rjehangir/PowerMonitor/README.md

PowerMonitor
============

Arduino-based power monitoring board with 4 channels for the SolarSurfer.
