rjehangir/PowerMonitor/eagle/power-monitor.brd

## EAGLE design eagle/power-monitor.brd (2014-09-27)

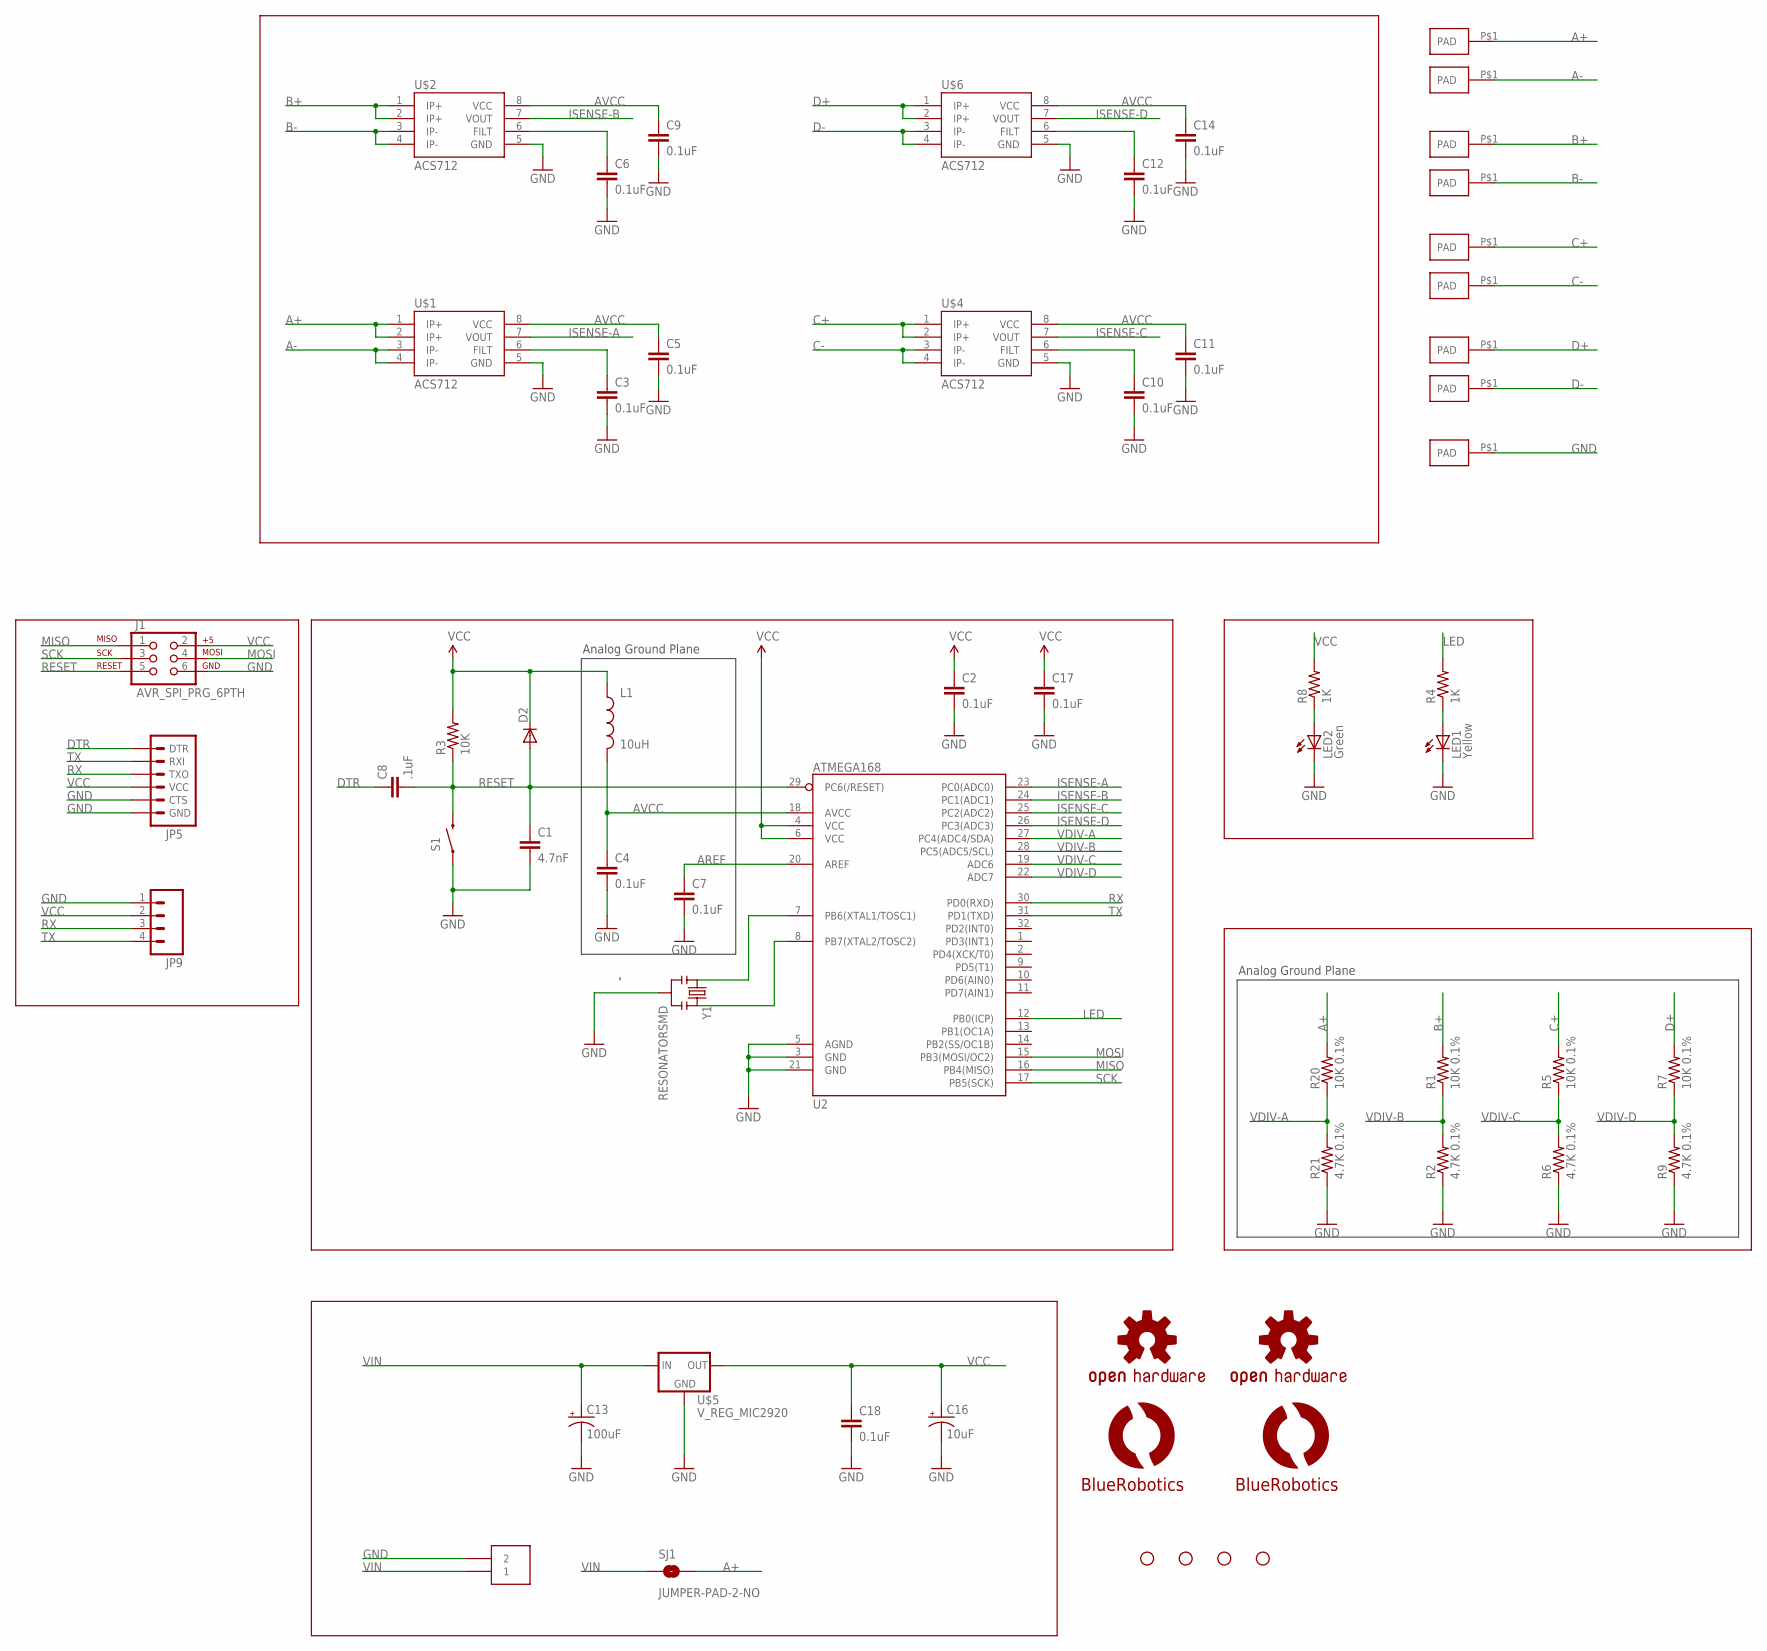
[picture p1: schematic power-monitor.sch]

Parts:
C1: 4.7nF; 0603-CAP
C2, C3, C4, C5, C6, C7, C9, C10, C11, C12, C14, C17, C18: 0.1uF; 0603-CAP
C8: .1uF; 0603-CAP
C13: 100uF; CPOL-RADIAL-100UF-25V
C16: 10uF; EIA3216
D2: DIODESOD; SOD-323
J1: AVR_SPI_PRG_6PTH; 2X3
JP5: ARDUINO_SERIAL_PROGRAMPTH; 1X06
JP9: M04PTH; 1X04
L1: 10uH; 0603
LED1: Yellow; LED-0603
LED2: Green; LED-0603
LOGO1: OSHW-LOGOS; OSHW-LOGO-S
LOGO2: OSHW-LOGOM; OSHW-LOGO-M
R1, R5, R7, R20: 10K 0.1%; 0603-RES
R2, R6, R9, R21: 4.7K 0.1%; 0603-RES
R3: 10K; 0603-RES
R4, R8: 1K; 0603-RES
S1: reset; TACTILE_SWITCH_SMD
SJ1: JUMPER-PAD-2-NO; PAD-JUMPER-2-NO_NO_SILK
STANDOFF1, STANDOFF2, STANDOFF3, STANDOFF4: STAND-OFF
U2: ATMEGA168; TQFP32-08
U$1, U$2, U$4, U$6: ACS712; SO08
U$3: TERMINAL-25MM-WEID; LSF-SMT-5MM-2
U$5: V_REG_MIC2920; SOT223
U$7, U$8, U$9, U$10, U$11, U$13, U$14, U$15, U$16: PADLARGE-ONE-SIDE; PAD-0.2X0.3-ONE-SIDE
U$17: LOGOBR-LOGO-M; BR-LOGO-MEDIUM
U$18: LOGOBR-LOGO-S; BR-LOGO-SMALL
Y1: RESONATORSMD; RESONATOR-SMD

Connections:
A+: R20.2, SJ1.2, U$1.1 (IP+), U$1.2 (IP+), U$13.P$1
A-: U$1.3 (IP-), U$1.4 (IP-), U$14.P$1
AREF: C7.1, U2.20 (AREF)
AVCC: C4.1, C5.1, C9.1, C11.1, C14.1, L1.2, U2.18 (AVCC), U$1.8 (VCC), U$2.8 (VCC), U$4.8 (VCC), U$6.8 (VCC)
B+: R1.2, U$2.1 (IP+), U$2.2 (IP+), U$15.P$1
B-: U$2.3 (IP-), U$2.4 (IP-), U$16.P$1
C+: R5.2, U$4.1 (IP+), U$4.2 (IP+), U$7.P$1
C-: U$4.3 (IP-), U$4.4 (IP-), U$8.P$1
D+: R7.2, U$6.1 (IP+), U$6.2 (IP+), U$9.P$1
D-: U$6.3 (IP-), U$6.4 (IP-), U$10.P$1
DTR: C8.1, JP5.1 (DTR)
GND: C1.2, C2.2, C3.2, C4.2, C5.2, C6.2, C7.2, C9.2, C10.2, C11.2, C12.2, C13.2 (-), C14.2, C16.C (-), C17.2, C18.2, J1.6, JP5.5 (CTS), JP5.6 (GND), JP9.1, LED1.C, LED2.C, R2.1, R6.1, R9.1, R21.1, S1.1, U2.3 (GND), U2.5 (AGND), U2.21 (GND), U$1.5 (GND), U$2.5 (GND), U$3.2, U$3.4 (2), U$4.5 (GND), U$5.2 (GND), U$6.5 (GND), U$11.P$1, Y1.2
ISENSE-A: U2.23 (PC0(ADC0)), U$1.7 (VOUT)
ISENSE-B: U2.24 (PC1(ADC1)), U$2.7 (VOUT)
ISENSE-C: U2.25 (PC2(ADC2)), U$4.7 (VOUT)
ISENSE-D: U2.26 (PC3(ADC3)), U$6.7 (VOUT)
LED: R4.2, U2.12 (PB0(ICP))
MISO: J1.1, U2.16 (PB4(MISO))
MOSI: J1.4, U2.15 (PB3(MOSI/OC2))
unnamed: C6.1, U$2.6 (FILT)
unnamed: C3.1, U$1.6 (FILT)
unnamed: LED1.A, R4.1
unnamed: C10.1, U$4.6 (FILT)
unnamed: C12.1, U$6.6 (FILT)
unnamed: U2.7 (PB6(XTAL1/TOSC1)), Y1.1
unnamed: U2.8 (PB7(XTAL2/TOSC2)), Y1.3
unnamed: LED2.A, R8.1
RESET: C1.1, C8.2, D2.2 (A), J1.5, R3.1, S1.3 (2), U2.29 (PC6(/RESET))
RX: JP5.3 (TXO), JP9.3, U2.30 (PD0(RXD))
SCK: J1.3, U2.17 (PB5(SCK))
TX: JP5.2 (RXI), JP9.4, U2.31 (PD1(TXD))
VCC: C2.1, C16.A (+), C17.1, C18.1, D2.1 (C), J1.2, JP5.4 (VCC), JP9.2, L1.1, R3.2, R8.2, U2.4 (VCC), U2.6 (VCC), U$5.3 (OUT)
VDIV-A: R20.1, R21.2, U2.27 (PC4(ADC4/SDA))
VDIV-B: R1.1, R2.2, U2.28 (PC5(ADC5/SCL))
VDIV-C: R5.1, R6.2, U2.19 (ADC6)
VDIV-D: R7.1, R9.2, U2.22 (ADC7)
VIN: C13.1 (+), SJ1.1, U$3.1, U$3.3 (1), U$5.1 (IN)

Notes on the sheet:
Analog Ground Plane

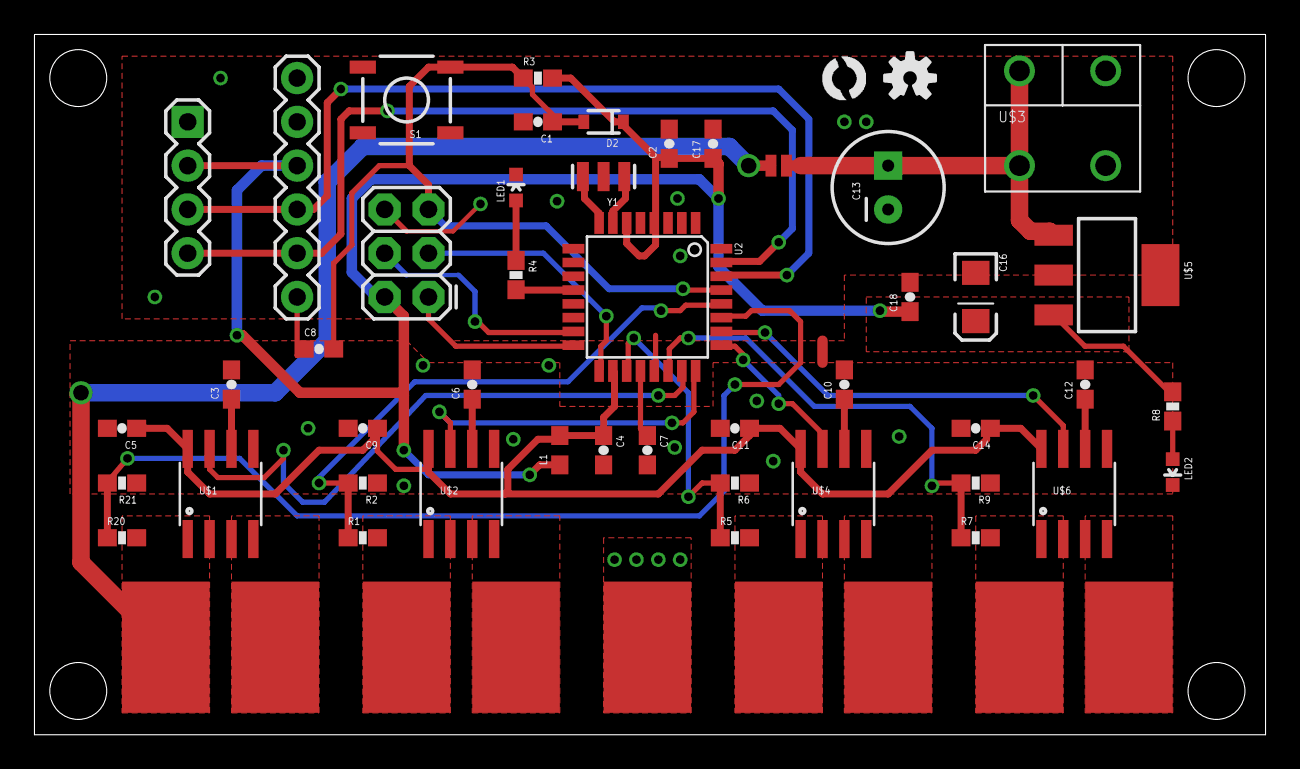
[picture p2: board power-monitor.brd from above]

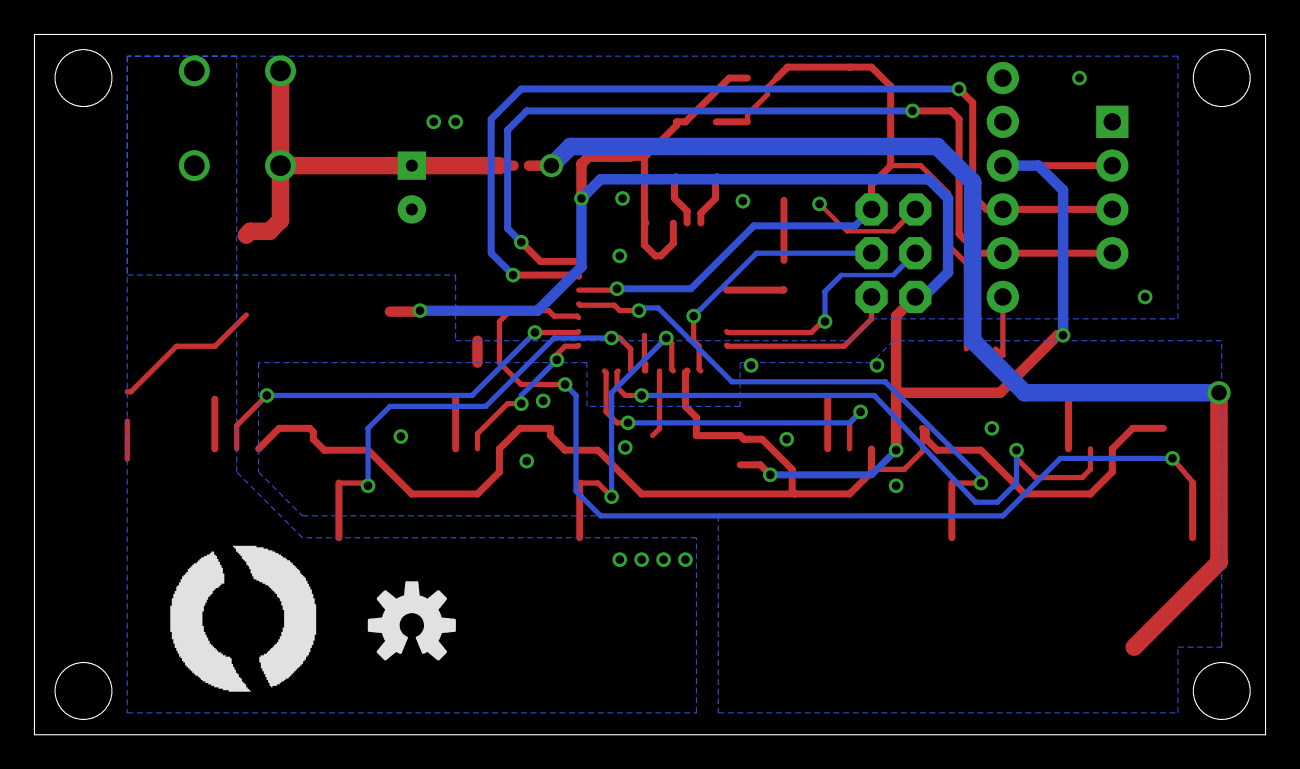
[picture p3: board power-monitor.brd from below]

Board: 2 copper layers, 71.4 x 40.6 mm, 62 parts (2 on the bottom side), 37 nets.
