rjehangir/PowerMonitor/(commit log)

2014-07-24 Tested the power monitor code successfully.
2014-09-27 Added Eagle files for the PowerMonitor board.
    [power-monitor.brd, power-monitor.sch]
